bigbadevilaussie-hue/Bike-Mate/bike.png

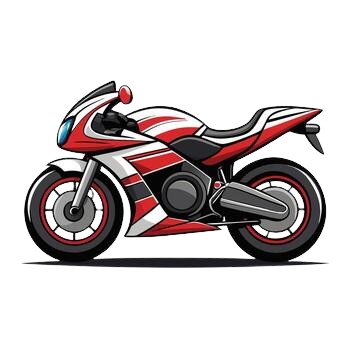
bike.png
