bigbadevilaussie-hue/Bike-Mate/bike_mate_veroboard_layout.png

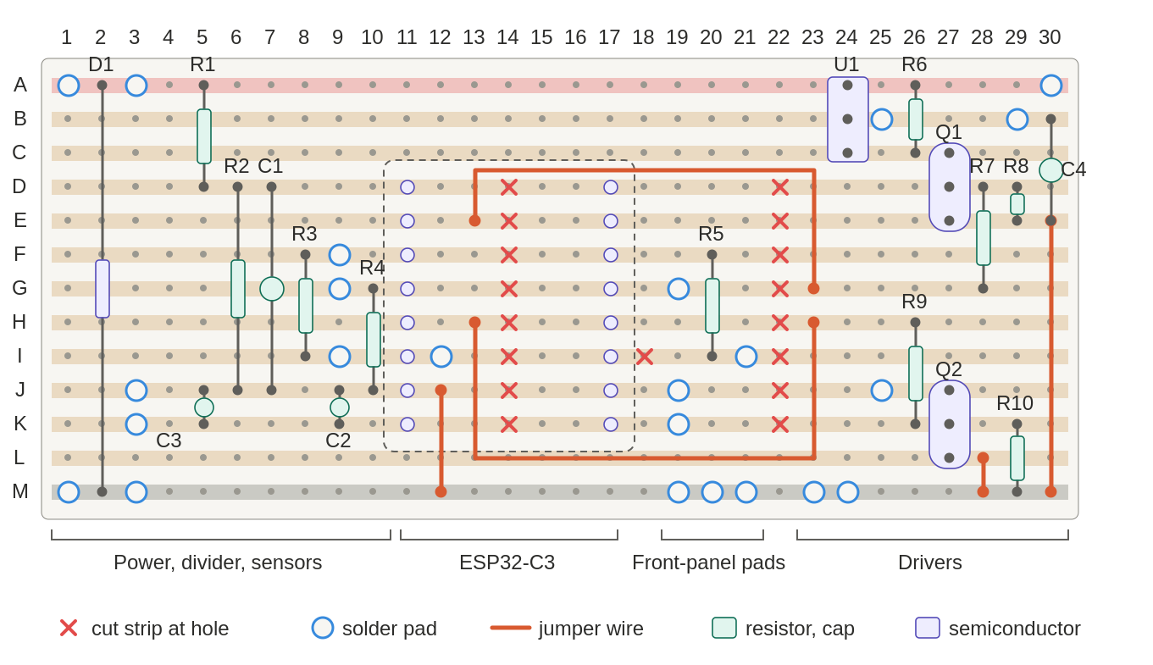
bike_mate_veroboard_layout.png
