bigbadevilaussie-hue/Bike-Mate/bike_mate_veroboard.xlsx

Sheet: Parts
Bike-Mate veroboard: parts (13 strips A-M x 30 holes)
Code | Part | Value | Qty | From hole | To hole | Function / notes | Fitted? (Yes/No)
D1 | TVS diode | SA16CA (bidirectional) | 1 | A2 | M2 | 12 V rail to GND, lay along column 2 | No
R1 | Resistor | 98.8k | 1 | A5 | D5 | Divider top (12 V to GPIO 0 node) | No
R2 | Resistor | 9.98k | 1 | D6 | J6 | Divider bottom (GPIO 0 to GND) | No
C1 | Capacitor | 100 nF ceramic | 1 | D7 | J7 | ADC filter on GPIO 0 | No
R3 | Resistor | 10k | 1 | F8 | I8 | GPS TX pull-up (GPIO 2 to 3V3) | No
R4 | Resistor | 10k | 1 | G10 | J10 | NTC series resistor (GPIO 3 to GND) | No
R5 | Resistor | 330 ohm | 1 | F20 | I20 | Red alarm LED (GPIO 10 to LED anode pad I21) | No
R6 | Resistor | 10k | 1 | A26 | C26 | IRF4905 gate pull-up. Mount upright | No
R7 | Resistor | 1k | 1 | D28 | G28 | Q1 base resistor (from GPIO 1 landing row G) | No
R8 | Resistor | 10k | 1 | D29 | E29 | Q1 base pull-down. Mount upright | No
R9 | Resistor | 1k | 1 | H26 | K26 | Q2 base resistor (from GPIO 4 landing row H) | No
R10 | Resistor | 10k | 1 | K29 | M29 | Q2 base pull-down. Mount upright | No
U1 | P-MOSFET | IRF4905 | 1 | A24 | C24 | Column 24: A = source, B = drain, C = gate | No
Q1 | NPN transistor | 2N2222 | 1 | C27 | E27 | Column 27: C = collector, D = base, E = emitter | No
Q2 | NPN transistor | 2N2222 | 1 | J27 | L27 | Column 27: J = collector, K = base, L = emitter | No
C2 | Capacitor | 100 nF ceramic | 1 | J9 | K9 | Decoupling across SuperMini 5V/GND, close to header (K = 5V, J = GND) | No
C3 | Capacitor | 10-47 uF electrolytic, 16 V or higher | 1 | J5 | K5 | Bulk on 5V rail. + lead to K5 (5V), - lead to J5 (GND) | No
C4 | Capacitor (optional) | 100 nF ceramic | 1 | B30 | E30 | Switched 12V rail near IRF4905 (B = switched 12V, E = GND). Shares hole E30 with W4 | No
Total parts |  |  | 18
Fitted |  |  | 0
Remaining |  |  | 18
Blue text in column H is for you to fill in (Yes or No).

Sheet: Jumpers
Jumper wires (5)
Code | From hole | To hole | Purpose
W1 | J12 | M12 | Module GND row to GND rail
W2 | E13 | G23 | GPIO 1 to IRF4905 driver (R7 landing row). Insulated wire, routed above the module pins
W3 | H13 | H23 | GPIO 4 to buzzer driver (R9 landing row). Insulated wire, routed below the module pins
W4 | E30 | M30 | Q1 emitter row to GND rail
W5 | L28 | M28 | Q2 emitter row to GND rail
Count | 5

Sheet: Pads
Solder pads (wires to off-board parts)
Hole | Net | Connects to | Wired? (Yes/No)
A1 | +12 V rail | 12 V in (after fuse and kill switch) | No
M1 | GND rail | GND in | No
A3 | +12 V rail | MP1584 IN+ | No
M3 | GND rail | MP1584 IN- | No
K3 | 5V | MP1584 OUT+ (5 V to SuperMini) | No
J3 | GND (module row) | MP1584 OUT- | No
F9 | GPIO 2 | GPS TX | No
G9 | GPIO 3 | NTC lead 1 | No
I9 | 3V3 | NTC lead 2 | No
I12 | 3V3 | OLED VCC | No
G19 | GPIO 9 | OLED SCL | No
J19 | GPIO 6 | OLED SDA | No
M20 | GND rail | OLED GND | No
K19 | GPIO 5 | Wake button | No
M19 | GND rail | Wake button return | No
I21 | LED anode net | Red alarm LED anode (via R5) | No
M21 | GND rail | Red alarm LED cathode | No
B25 | Switched 12 V | Mini 360 IN+ (or USB charger +) | No
B29 | Switched 12 V | USB charger + (or Mini 360 IN+) | No
M23 | GND rail | Mini 360 IN- | No
M24 | GND rail | USB charger - | No
A30 | +12 V rail | Buzzer + (SFM-27 red) | No
J25 | Buzzer - net | Buzzer - (SFM-27 black, Q2 collector row) | No
Pads |  | 23
Wired |  | 0

Sheet: Cuts
Strip cuts (remove copper at the hole, check with continuity)
Column | Rows | Purpose | Cuts
14 | D to K | Separates left and right module header groups | 8
22 | D to K | Separates module pad area from driver zone | 8
18 | I only | Isolates unused GPIO 7 pin from the LED pad island | 1
Total cuts |  |  | 17

Sheet: Module pins
SuperMini on rows D-K, USB-C end toward the GND rail (verify against your silkscreen)
Row | Left header (col 11) | Left use | Right header (col 17) | Right use
D | GPIO 0 | Voltage divider node (R1, R2, C1) | GPIO 21 | Unused
E | GPIO 1 | IRF4905 driver via W2 | GPIO 20 | Unused
F | GPIO 2 | GPS TX and R3 pull-up | GPIO 10 | Alarm LED via R5
G | GPIO 3 | NTC network | GPIO 9 | OLED SCL pad (G19)
H | GPIO 4 | Buzzer driver via W3 | GPIO 8 | Unused (onboard LED)
I | 3V3 | 3V3 net (R3, NTC, OLED VCC) | GPIO 7 | Unused
J | GND | GND (tied to rail by W1) | GPIO 6 | OLED SDA pad (J19)
K | 5V | 5 V from MP1584 | GPIO 5 | Wake button pad (K19)

Sheet: Build steps
Build order
Step | Task | Done? (Yes/No)
1 | Trim board to 13 strips x 30 holes
2 | Make the 17 cuts and check each with continuity
3 | Fit female headers at columns 11 and 17 (rows D-K)
4 | Fit resistors, C1 and D1 (stand R6, R8, R10 upright)
5 | Fit U1, Q1 and Q2 (check pin order, flip 180 degrees if needed)
6 | Add the five jumper wires
7 | Wire the pads to the off-board parts
8 | Continuity check: no short between rail A and rail M, no unintended links between rows
9 | Power up without the SuperMini: confirm 5 V, 3V3 and GND at its sockets
10 | Insert the SuperMini, then check voltage reading and sleep current
Progress |  | 0%

Sheet: Notes
Assumptions and checks
Layout designed from veroboard.txt (Bike-Mate V5.63). It is untested: verify every cut and connection with a continuity tester before powering.
Grid: rows A-M are strips running left to right, columns 1-30. Row A is the +12 V rail, row M is the GND rail.
Module headers assumed 6 holes apart (columns 11 and 17). If yours are 7 holes apart, shift everything right of the module by one column and move the first cut to the midpoint.
SuperMini pin order assumed: left header GPIO 0,1,2,3,4,3V3,GND,5V; right header GPIO 21,20,10,9,8,7,6,5 (USB-C toward the GND rail). Confirm against your board.
Check 2N2222 and IRF4905 pin order; flip each part 180 degrees if the collector or gate lands on the wrong row.
R6, R8 and R10 have only 1-2 holes between their rows, so mount them upright.
MP1584, Mini 360, USB charger, GPS, fan, OLED, buzzer, NTC, button and LED connect by wire to the pads; their footprints are not on the board.
C2, C3 and C4 were added after the first layout (recommended extra capacitors). C4 is optional.
GPIO 2 and GPIO 9 are strapping pins and must be high at reset. Measure sleep current with ACC off (see veroboard.txt known issues).
