bigbadevilaussie-hue/Bike-Mate/Bike-Mate-Case.3mf

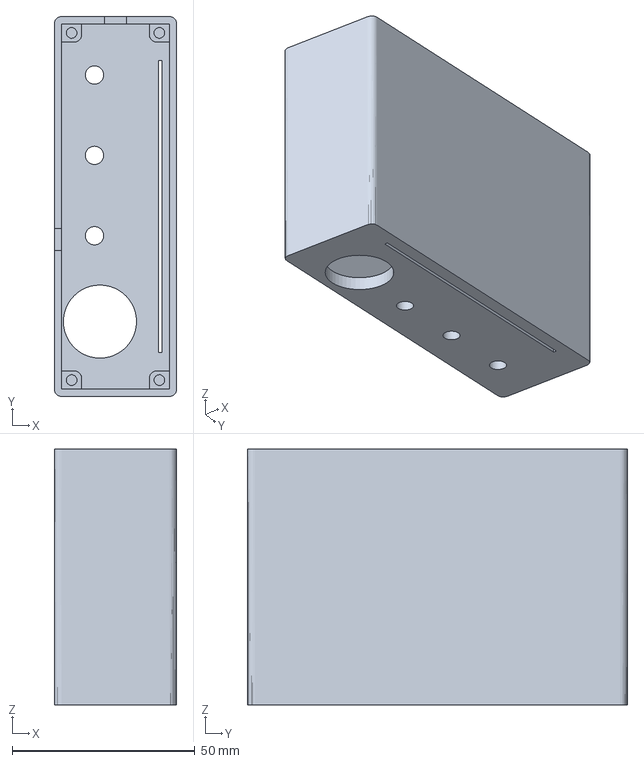
[picture p3: CAD file, 2026-10-31]
Bike-Mate-Case.3mf
33.5 x 104.0 x 70.0 mm
