bigbadevilaussie-hue/Bike-Mate/(list of files, cad)

Other CAD files:
Bike-Mate-Case.stl
