bigbadevilaussie-hue/Bike-Mate/bike_mate.kicad_sch

## KiCad design bike_mate.kicad_sch (2026-10-15)

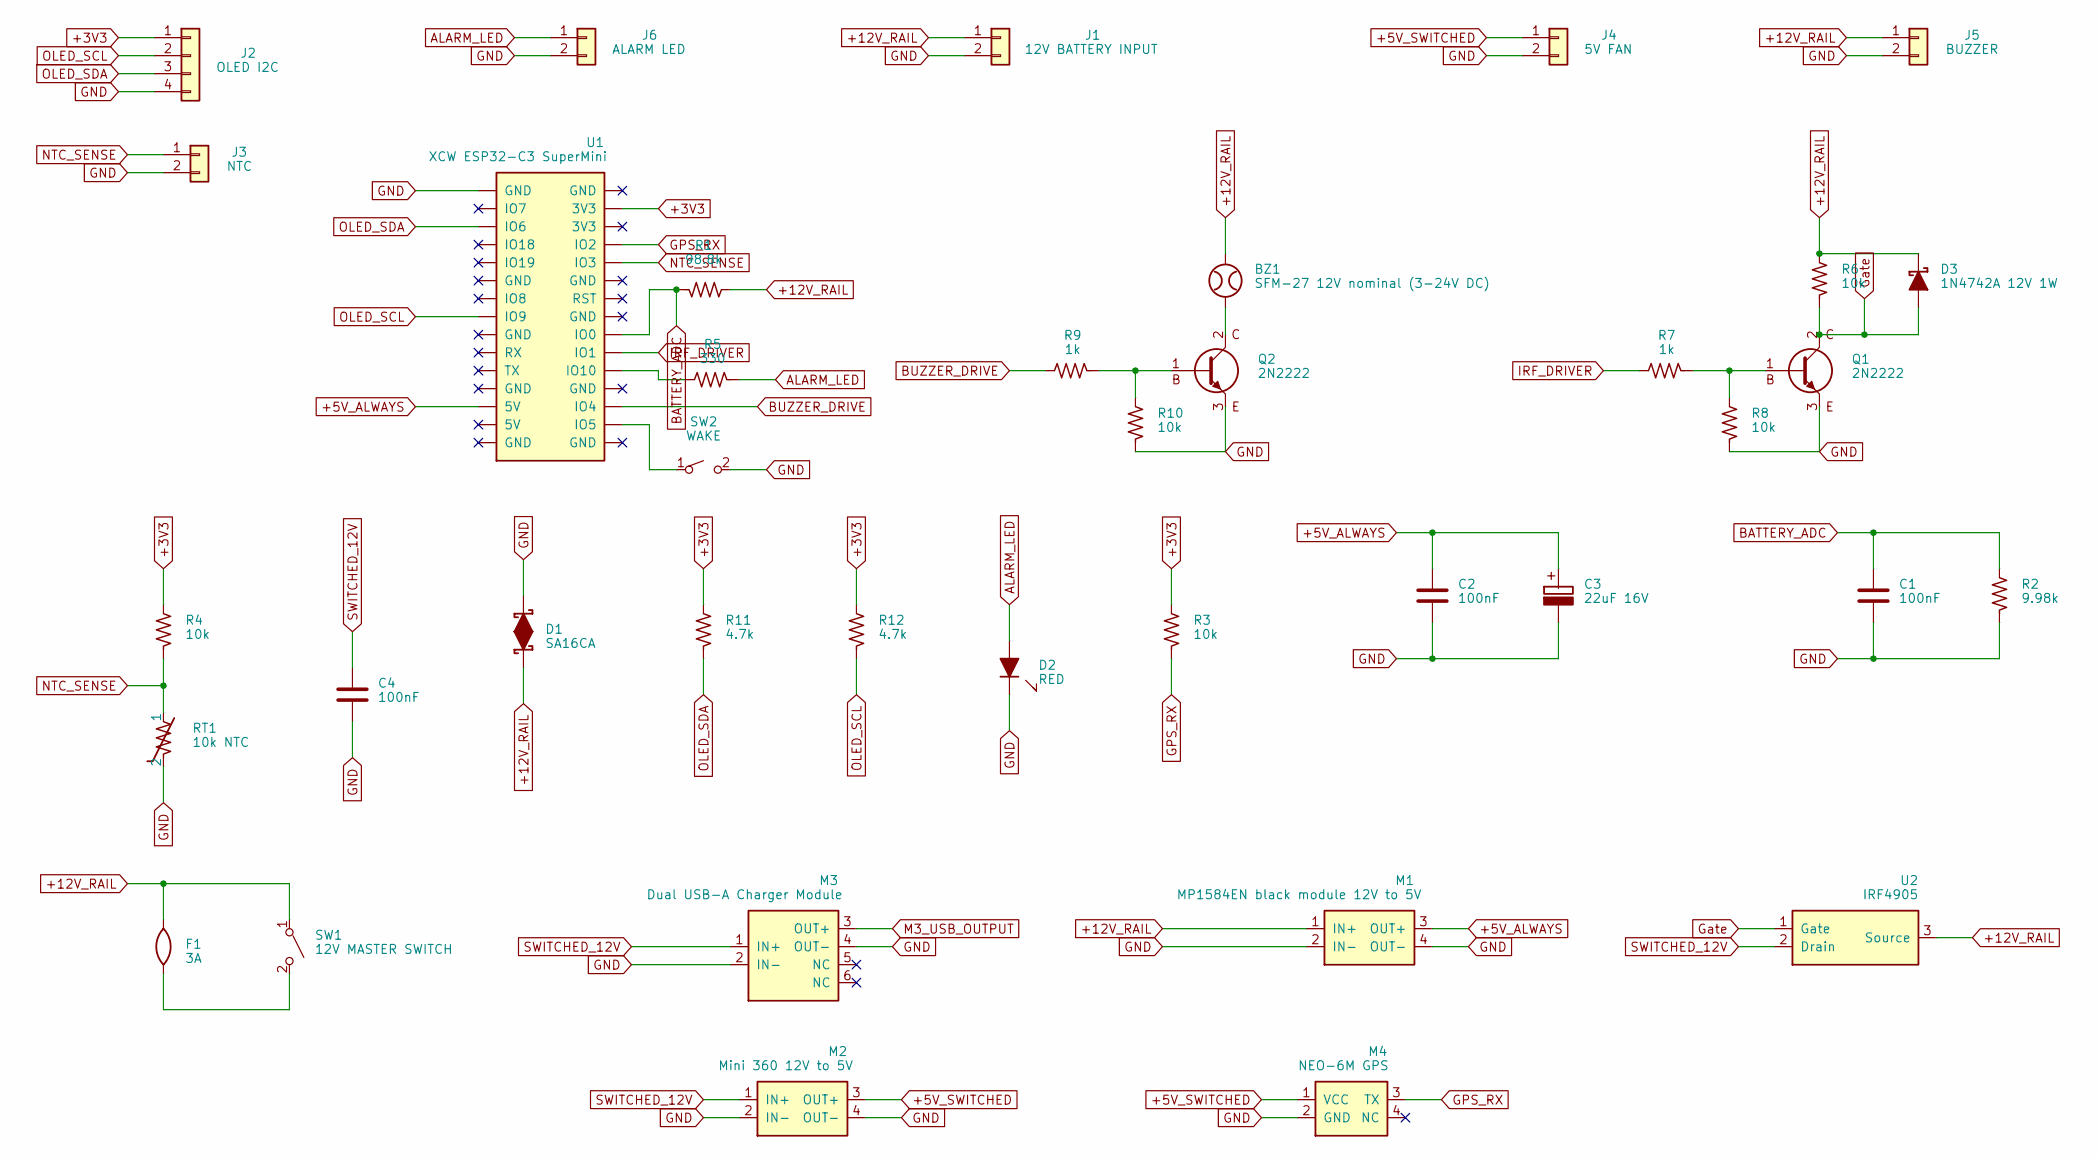
[picture p5: schematic bike_mate.kicad_sch]

Parts:
BZ1: SFM-27 12V nominal (3-24V DC)
C1, C2, C4: 100nF
C3: 22uF 16V
D1: SA16CA
D2: RED
D3: 1N4742A 12V 1W
F1: 3A
J1: 12V BATTERY INPUT
J2: OLED I2C
J3: NTC
J4: 5V FAN
J5: BUZZER
J6: ALARM LED
M1: MP1584EN black module 12V to 5V
M2: Mini 360 12V to 5V
M3: Dual USB-A Charger Module
M4: NEO-6M GPS
Q1, Q2: 2N2222
R1: 98.8k
R2: 9.98k
R3, R4, R6, R8, R10: 10k
R5: 330
R7, R9: 1k
R11, R12: 4.7k
RT1: 10k NTC
SW1: 12V MASTER SWITCH
SW2: WAKE
U1: XCW ESP32-C3 SuperMini
U2: IRF4905

Connections:
+3V3: J2.1, R3.1, R4.1, R11.1, R12.1, U1.3V3_1 (3V3)
+5V_ALWAYS: C2.1, C3.1, M1.3 (OUT+), U1.5V_1 (5V)
+5V_SWITCHED: J4.1, M2.3 (OUT+), M4.1 (VCC)
+12V_RAIL: BZ1.1 (+), D1.1, D3.1 (K), F1.2, J1.1, J5.1, M1.1 (IN+), R1.1, R6.1, SW1.1, U2.3 (Source)
ALARM_LED: D2.2 (A), J6.1, R5.2
BATTERY_ADC: C1.1, R1.2, R2.1, U1.GPIO0 (IO0)
BUZZER_DRIVE: R9.1, U1.GPIO4 (IO4)
GND: C1.2, C2.2, C3.2, C4.2, D1.2, D2.1 (K), J1.2, J2.4, J3.2, J4.2, J5.2, J6.2, M1.2 (IN-), M1.4 (OUT-), M2.2 (IN-), M2.4 (OUT-), M3.2 (IN-), M3.4 (OUT-), M4.2 (GND), Q1.3 (E), Q2.3 (E), R2.2, R8.2, R10.2, RT1.2, SW2.2, U1.GND1 (GND)
GPS_RX: M4.3 (TX), R3.2, U1.GPIO2 (IO2)
Gate: D3.2 (A), Q1.2 (C), R6.2, U2.1 (Gate)
IRF_DRIVER: R7.1, U1.GPIO1 (IO1)
M3_USB_OUTPUT: M3.3 (OUT+)
NTC_SENSE: J3.1, R4.2, RT1.1, U1.GPIO3 (IO3)
unnamed: BZ1.2 (-), Q2.2 (C)
unnamed: F1.1, SW1.2
unnamed: Q1.1 (B), R7.2, R8.1
unnamed: Q2.1 (B), R9.2, R10.1
unnamed: R5.1, U1.GPIO10 (IO10)
unnamed: SW2.1, U1.GPIO5 (IO5)
OLED_SCL: J2.2, R12.2, U1.GPIO9 (IO9)
OLED_SDA: J2.3, R11.2, U1.GPIO6 (IO6)
SWITCHED_12V: C4.1, M2.1 (IN+), M3.1 (IN+), U2.2 (Drain)
