bigbadevilaussie-hue/Bike-Mate/BleManager.cpp

#include "BleManager.h"
#include "Config.h"
#include "RideLogger.h"
#include "RideStorage.h"
#include "Settings.h"

#include <Preferences.h>
#include <esp_bt.h>
#include <LittleFS.h>
#include <string>
#include <time.h>

extern Preferences prefs;
extern uint32_t currentEpoch();
extern void tprint(const char* fmt, ...);
extern unsigned long lastDisconnectMillis;

extern bool gpsHasFix();
extern int32_t gpsLat_x1e7();
extern int32_t gpsLon_x1e7();
extern uint8_t gpsSats();

BLEServer* pServer = nullptr;
BLECharacteristic* pDataChar = nullptr;
BLECharacteristic* pTimeChar = nullptr;
BLECharacteristic* pStreamChar = nullptr;
BLECharacteristic* pRequestChar = nullptr;
BLECharacteristic* pOtaChar = nullptr;
BLECharacteristic* pSettingsChar = nullptr;
BLECharacteristic* pUploadChar = nullptr;   // V5.37
volatile bool maintenanceModeRequested = false;
volatile unsigned long lastBleWriteMs = 0;   // V4.84: last incoming BLE write

bool bleInited = false;

// V5.37.7: set while bleSendFile is transferring. Read by
// DisplayManager to show the upload screen on the OLED.
volatile bool bleUploadActive = false;

volatile bool pushRequested = false;
volatile bool pushInProgress = false;
volatile uint32_t pushGuiEpoch = 0;

// V5.77: Heartbeat tracking
RTC_DATA_ATTR uint32_t _bootCount = 0;
static unsigned long _lastHbMs = 0;

// V5.76: ACK queue. onWrite just queues the filename.
// The main loop processes it, so we don't run LittleFS inside the BT task.
#define ACK_QUEUE_SIZE 8
static char _ackQueue[ACK_QUEUE_SIZE][48];
static volatile int _ackHead = 0;
static volatile int _ackTail = 0;

static volatile bool bleSuspended = false;

extern float latestBatteryVoltage;
extern float latestTemperatureC;
extern bool accState;
extern bool engineWasRunning;
extern bool inPanic;
extern bool isLogging;
extern const char* currentStateString();

bool isActuallyConnected() {
  return pServer && pServer->getConnectedCount() > 0;
}

void bleStop() {
  if (!bleInited) return;

  bleSuspended = true;

  delay(50);

  if (pServer) {
    pServer->getAdvertising()->stop();

    if (pServer->getConnectedCount() > 0) {
      pServer->disconnect(pServer->getConnId());
    }
  }

  // V4.86: wait for the BT controller to actually go idle before
  // returning. WiFi bring-up tears down and re-inits the shared radio;
  // if the BT side is still mid-teardown the WiFi driver never leaves
  // WL_IDLE_STATUS and association times out. Bounded so a stuck
  // controller can't pin us here.
  unsigned long t0 = millis();
  while (millis() - t0 < 2000UL) {
    esp_bt_controller_status_t st = esp_bt_controller_get_status();
    if (st == ESP_BT_CONTROLLER_STATUS_IDLE ||
        st == ESP_BT_CONTROLLER_STATUS_INITED) {
      break;
    }
    delay(20);
  }

  delay(200);
}

void bleStart() {
  if (!bleInited) return;

  bleSuspended = false;

  if (pServer) {
    pServer->getAdvertising()->start();
  }
}

static bool isHeaderLine(const String& line) {
  if (line.length() == 0) return true;
  if (line.startsWith("#")) return true;
  if (line.startsWith("epoch,")) return true;
  return false;
}

void pushNewSlots(uint32_t guiHighestEpoch) {
  pushInProgress = true;

  prefs.begin("rides", true);

  uint32_t newestEpoch = prefs.getUInt("newest_epoch", 0);

  RideSummary newest;
  memset(&newest, 0, sizeof(newest));

  if (newestEpoch > 0) {
    char key[16];

    snprintf(key, sizeof(key), "s%lu",
             (unsigned long)newestEpoch);

    size_t sz = prefs.getBytes(
        key,
        &newest,
        sizeof(newest));

    if (sz != sizeof(newest)) {
      newestEpoch = 0;
    }
  }

  prefs.end();

  if (newestEpoch == 0) {
    uint8_t r = 0x00;

    if (pRequestChar) {
      pRequestChar->setValue(&r, 1);
      pRequestChar->notify();
    }

    pushInProgress = false;
    return;
  }

  if (newestEpoch <= guiHighestEpoch) {
    uint8_t r = 0x00;

    if (pRequestChar) {
      pRequestChar->setValue(&r, 1);
      pRequestChar->notify();
    }

    pushInProgress = false;
    return;
  }

  uint8_t r = 0x01;

  if (pRequestChar) {
    pRequestChar->setValue(&r, 1);
    pRequestChar->notify();
  }

  delay(80);

  pStreamChar->setValue(
      (uint8_t*)&newest,
      sizeof(newest));

  pStreamChar->notify();

  delay(100);

  char path[40];

  setenv("TZ", "AEST-10", 1);
  tzset();

  rideStorageBuildFilename(
      newestEpoch,
      path,
      sizeof(path));

  File f = LittleFS.open(path, "r");

  if (!f) {
    tprint("[PUSH] file not found %s (clearing newest_epoch)", path);

    prefs.begin("rides", false);
    prefs.putUInt("newest_epoch", 0);
    prefs.end();

    r = 0x00;

    if (pRequestChar) {
      pRequestChar->setValue(&r, 1);
      pRequestChar->notify();
    }

    pushInProgress = false;
    return;
  }

  while (f.available()) {
    int peek = f.peek();

    if (peek == '#' || peek == 'e') {
      f.readStringUntil('\n');
    } else {
      break;
    }
  }

  uint16_t sent = 0;
  uint8_t buf[8];

  while (f.available() && sent < newest.rowCount) {
    String line = f.readStringUntil('\n');

    if (isHeaderLine(line)) {
      continue;
    }

    uint32_t ep = 0;
    int32_t lat = 0;
    int32_t lon = 0;
    float v = 0;
    int temp = 0;
    int sats = 0;

    int parsed = sscanf(
        line.c_str(),
        "%lu,%ld,%ld,%f,%d,%d",
        (unsigned long*)&ep,
        (long*)&lat,
        (long*)&lon,
        &v,
        &temp,
        &sats);

    if (parsed < 6) {
      continue;
    }

    uint16_t v100 = (uint16_t)(v * 100);

    memcpy(buf + 0, &ep, 4);
    memcpy(buf + 4, &v100, 2);

    buf[6] = (uint8_t)temp;
    buf[7] = (uint8_t)sats;

    pStreamChar->setValue(buf, 8);
    pStreamChar->notify();

    sent++;

    delay(40);
  }

  f.close();

  if (isActuallyConnected()) {
    r = 0x02;

    if (pRequestChar) {
      pRequestChar->setValue(&r, 1);
      pRequestChar->notify();
    }
  }

  delay(100);

  pushInProgress = false;
}

class ServerCallbacks : public BLEServerCallbacks {
  void onConnect(BLEServer* s) {

    delay(300);

    char vbuf[32];

    snprintf(
        vbuf,
        sizeof(vbuf),
        "{\"fv\":\"%s\"}",
        BIKE_MATE_VERSION);

    if (pDataChar) {
      pDataChar->setValue(
          (uint8_t*)vbuf,
          strlen(vbuf));

      pDataChar->notify();
    }
  }

  void onDisconnect(BLEServer* s) {
    lastDisconnectMillis = millis();

    if (!bleSuspended && pServer) {
      pServer->getAdvertising()->start();
    }
  }
};

class TimeCallbacks : public BLECharacteristicCallbacks {
  void onWrite(BLECharacteristic* c) {
    lastBleWriteMs = millis();
    std::string v = c->getValue();

    if (v.length() < 4) return;

    uint32_t t = 0;

    memcpy(&t, v.c_str(), 4);

    if (t < 1700000000UL ||
        t > 4102444800UL) {
      return;
    }

    struct timeval tv = { .tv_sec = (time_t)t, .tv_usec = 0 };
    settimeofday(&tv, NULL);
  }
};

class RequestCallbacks : public BLECharacteristicCallbacks {
  void onWrite(BLECharacteristic* c) {
    lastBleWriteMs = millis();
    std::string v = c->getValue();

    if (v.length() < 4) return;

    uint32_t epoch = 0;

    memcpy(&epoch, v.c_str(), 4);

    pushGuiEpoch = epoch;
    pushRequested = true;
  }
};

class OtaCallbacks : public BLECharacteristicCallbacks {
  void onWrite(BLECharacteristic* c) {
    lastBleWriteMs = millis();
    std::string v = c->getValue();

    // Settings read: single byte 0x01 -> notify JSON on same characteristic
    if (v.length() == 1 && (uint8_t)v[0] == 0x01) {
      char sbuf[192];
      settingsToJson(sbuf, sizeof(sbuf));
      pOtaChar->setValue((uint8_t*)sbuf, strlen(sbuf));
      pOtaChar->notify();
      tprint("[SETTINGS] read served: %s", sbuf);
      return;
    }

    // V4.75: maintenance mode command. Payload is {"maint":"on"} or {"maint":"off"}.
    // "on" -> set flag, ACK over BLE, then main loop brings WiFi up.
    // "off" -> ignored here; the off path is HTTP /maint/off, since BLE
    //          is dead while maintenance is running.
    if (v.length() > 1) {
      String mv = String(v.c_str());
      int mi = mv.indexOf("\"maint\":\"");
      if (mi >= 0) {
        int vs = mi + 9;
        int ve = mv.indexOf("\"", vs);
        if (ve > vs) {
          String val = mv.substring(vs, ve);
          if (val == "on") {
            extern bool maintRequest;
            maintRequest = true;
            uint8_t ack = 0x01;
            pOtaChar->setValue(&ack, 1);
            pOtaChar->notify();
            tprint("[MAINT] on requested (flag set, will act on next wake)");
          } else if (val == "off") {
            uint8_t nack = 0x02;
            pOtaChar->setValue(&nack, 1);
            pOtaChar->notify();
            tprint("[MAINT] off over BLE ignored, use /maint/off");
          } else {
            uint8_t nack = 0xFF;
            pOtaChar->setValue(&nack, 1);
            pOtaChar->notify();
            tprint("[MAINT] unknown value");
          }
        }
        return;
      }
    }

    // V5.37.6: manual upload trigger from OSA. Payload is {"cmd":"upload"}.
    // Sets a flag the main loop reads on the next doStateWork pass,
    // which runs the same BLE-send path the 04:00 schedule uses.
    if (v.length() > 1) {
      String cv = String(v.c_str());
      if (cv.indexOf("\"cmd\":\"upload\"") >= 0) {
        extern bool bleUploadNowRequested;
        bleUploadNowRequested = true;
        uint8_t ack = 0x01;
        pOtaChar->setValue(&ack, 1);
        pOtaChar->notify();
        tprint("[UPLOAD] manual trigger over BLE (flag set)");
        return;
      }
    }

    // Settings apply: multi-byte payload containing "voltage"
    if (v.length() > 1) {
      String sv = String(v.c_str());
      if (sv.indexOf("\"voltage\"") >= 0) {
        if (settingsApplyJson(sv.c_str())) {
          uint8_t ok = 0x01;
          pOtaChar->setValue(&ok, 1);
          pOtaChar->notify();
          tprint("[SETTINGS] apply OK");
        } else {
          uint8_t err = 0xFF;
          pOtaChar->setValue(&err, 1);
          pOtaChar->notify();
          tprint("[SETTINGS] apply FAIL");
        }
        return;
      }
    }

    // V5.76: OSA acks a file transfer. Queue the filename.
    // The main loop deletes it. Never touch LittleFS or tprint here.
    if (v.length() > 1) {
      String av = String(v.c_str());
      int ai = av.indexOf("\"ack\":");
      if (ai >= 0) {
        int as = ai + 6;
        while (as < (int)av.length() && av[as] == ' ') as++;
        int q1 = av.indexOf("\"", as);
        if (q1 >= as) {
          int q2 = av.indexOf("\"", q1 + 1);
          if (q2 > q1) {
            String fname = av.substring(q1 + 1, q2);
            int next = (_ackHead + 1) % ACK_QUEUE_SIZE;
            if (next != _ackTail) {
              snprintf(_ackQueue[_ackHead], sizeof(_ackQueue[_ackHead]), "%s", fname.c_str());
              _ackHead = next;
            }
          }
        }
        return;
      }
    }

    if (v.length() < 8) {
      uint8_t nack = 0xFF;

      pOtaChar->setValue(&nack, 1);
      pOtaChar->notify();

      return;
    }

    String payload = String(v.c_str());

    int urlIdx = payload.indexOf("\"url\":\"");
    int urlEnd = payload.indexOf("\"", urlIdx + 7);

    if (urlIdx < 0 || urlEnd < 0) {
      tprint("[OTA] parse: no url");

      uint8_t nack = 0xFF;

      pOtaChar->setValue(&nack, 1);
      pOtaChar->notify();

      return;
    }

    String url =
        payload.substring(urlIdx + 7, urlEnd);

    uint32_t size = 0;

    int sizeIdx =
        payload.indexOf("\"size\":");

    if (sizeIdx > 0) {
      int sizeEnd =
          payload.indexOf(",", sizeIdx);

      if (sizeEnd < 0) {
        sizeEnd =
            payload.indexOf("}", sizeIdx);
      }

      if (sizeEnd > 0) {
        String sizeStr =
            payload.substring(
                sizeIdx + 7,
                sizeEnd);

        size = (uint32_t)sizeStr.toInt();
      }
    }

    String md5 = "";

    int md5Idx =
        payload.indexOf("\"md5\":\"");

    if (md5Idx >= 0) {
      int md5End =
          payload.indexOf("\"", md5Idx + 7);

      if (md5End > 0) {
        md5 =
            payload.substring(
                md5Idx + 7,
                md5End);
      }
    }

    String ver = "";

    int verIdx =
        payload.indexOf("\"ver\":\"");

    if (verIdx >= 0) {
      int verEnd =
          payload.indexOf("\"", verIdx + 7);

      if (verEnd > 0) {
        ver =
            payload.substring(
                verIdx + 7,
                verEnd);
      }
    }

    extern volatile bool otaRequest;
    extern char otaUrl[];
    extern uint32_t otaSize;
    extern char otaMd5[];
    extern char otaVersion[16];
    extern unsigned long otaStartMillis;

    if (url.length() == 0 ||
        url.length() >= OTA_URL_MAX) {

      tprint("[OTA] url bad length");

      uint8_t nack = 0xFF;

      pOtaChar->setValue(&nack, 1);
      pOtaChar->notify();

      return;
    }

    strncpy(
        otaUrl,
        url.c_str(),
        OTA_URL_MAX - 1);

    otaUrl[OTA_URL_MAX - 1] = 0;

    otaSize = size;

    strncpy(
        otaMd5,
        md5.c_str(),
        OTA_MD5_LEN - 1);

    otaMd5[OTA_MD5_LEN - 1] = 0;

    strncpy(
        otaVersion,
        ver.c_str(),
        15);

    otaVersion[15] = 0;

    otaStartMillis = millis();
    otaRequest = true;

    uint8_t ack = 0x01;

    pOtaChar->setValue(&ack, 1);
    pOtaChar->notify();
  }
};

class SettingsCallbacks : public BLECharacteristicCallbacks {
  void onWrite(BLECharacteristic* c) override {
    lastBleWriteMs = millis();
    std::string v = c->getValue();
    if (v.length() == 0) return;

    // Read request: single byte 0x01 -> send current settings via notify
    if (v.length() == 1 && (uint8_t)v[0] == 0x01) {
      char sbuf[192];
      settingsToJson(sbuf, sizeof(sbuf));
      pSettingsChar->setValue((uint8_t*)sbuf, strlen(sbuf));
      pSettingsChar->notify();
      tprint("[SETTINGS] read request served: %s", sbuf);
      return;
    }

    String payload = String(v.c_str());
    tprint("[SETTINGS] RX: %s", payload.c_str());
    if (settingsApplyJson(payload.c_str())) {
      uint8_t ok = 0x01;
      pSettingsChar->setValue(&ok, 1);
      pSettingsChar->notify();
      tprint("[SETTINGS] apply OK");
    } else {
      uint8_t err = 0xFF;
      pSettingsChar->setValue(&err, 1);
      pSettingsChar->notify();
      tprint("[SETTINGS] apply FAIL");
    }
  }
};

void bleInit() {
  if (bleInited) return;
  _bootCount++;

  BLEDevice::init(DEVICE_NAME);
  BLEDevice::setMTU(185);

  pServer = BLEDevice::createServer();

  pServer->setCallbacks(
      new ServerCallbacks());

  BLEService* svc =
      pServer->createService(BLEUUID(SERVICE_UUID), 30, 0);

  pDataChar = svc->createCharacteristic(
      DATA_UUID,
      BLECharacteristic::PROPERTY_READ |
      BLECharacteristic::PROPERTY_NOTIFY);

  pDataChar->addDescriptor(
      new BLE2902());

  pTimeChar = svc->createCharacteristic(
      TIME_UUID,
      BLECharacteristic::PROPERTY_WRITE);

  pTimeChar->setCallbacks(
      new TimeCallbacks());

  pStreamChar = svc->createCharacteristic(
      STREAM_UUID,
      BLECharacteristic::PROPERTY_NOTIFY);

  pStreamChar->addDescriptor(
      new BLE2902());

  pRequestChar = svc->createCharacteristic(
      REQUEST_UUID,
      BLECharacteristic::PROPERTY_WRITE |
      BLECharacteristic::PROPERTY_NOTIFY);

  pRequestChar->addDescriptor(
      new BLE2902());

  pRequestChar->setCallbacks(
      new RequestCallbacks());

  pOtaChar = svc->createCharacteristic(
      OTA_UUID,
      BLECharacteristic::PROPERTY_WRITE |
      BLECharacteristic::PROPERTY_NOTIFY);

  pOtaChar->addDescriptor(
      new BLE2902());

  pOtaChar->setCallbacks(
      new OtaCallbacks());

  pSettingsChar = svc->createCharacteristic(
      SETTINGS_UUID,
      BLECharacteristic::PROPERTY_READ |
      BLECharacteristic::PROPERTY_WRITE |
      BLECharacteristic::PROPERTY_NOTIFY);
  pSettingsChar->addDescriptor(new BLE2902());
  pSettingsChar->setCallbacks(new SettingsCallbacks());
  {
    char sbuf[192];
    settingsToJson(sbuf, sizeof(sbuf));
    pSettingsChar->setValue((uint8_t*)sbuf, strlen(sbuf));
  }

  pUploadChar = svc->createCharacteristic(
      UPLOAD_UUID,
      BLECharacteristic::PROPERTY_NOTIFY);

  pUploadChar->addDescriptor(
      new BLE2902());

  svc->start();

  BLEAdvertising* adv =
      BLEDevice::getAdvertising();

  adv->addServiceUUID(SERVICE_UUID);
  adv->setScanResponse(true);

  bleInited = true;
}

extern const char* currentWakeMode();

// V5.37: send a file over BLE in 180-byte chunks.
bool bleSendFile(const char* path, const char* uploadName) {
  if (!pUploadChar || !bleInited) return false;
  if (!isActuallyConnected()) return false;

  bleUploadActive = true;

  File f = LittleFS.open(path, "r");
  if (!f) {
    tprint("[BLEUP] cannot open %s", path);
    bleUploadActive = false;
    return false;
  }

  size_t total = f.size();
  if (total == 0) { f.close(); bleUploadActive = false; return true; }

  uint8_t hdr[181];
  hdr[0] = 0x01;
  memcpy(hdr + 1, &total, 4);
  size_t nameLen = strlen(uploadName);
  if (nameLen > 176) nameLen = 176;
  memset(hdr + 5, 0, 176);
  memcpy(hdr + 5, uploadName, nameLen);
  pUploadChar->setValue(hdr, 181);
  pUploadChar->notify();
  delay(60);

  uint8_t buf[181];
  buf[0] = 0x02;
  size_t sent = 0;
  while (sent < total) {
    size_t n = f.read(buf + 1, 180);
    if (n == 0) break;
    if (n < 180) memset(buf + 1 + n, 0, 180 - n);
    pUploadChar->setValue(buf, 181);
    pUploadChar->notify();
    sent += n;
    delay(35);
  }
  f.close();

  uint8_t endBuf[5];
  endBuf[0] = 0x03;
  uint32_t crc = 0;
  memcpy(endBuf + 1, &crc, 4);
  pUploadChar->setValue(endBuf, 5);
  pUploadChar->notify();
  delay(40);

  tprint("[BLEUP] sent %s (%u bytes)", uploadName, (unsigned)total);
  bleUploadActive = false;
  return (sent == total);
}

void processAckQueue() {
  while (_ackTail != _ackHead) {
    char fname[48];
    strncpy(fname, _ackQueue[_ackTail], sizeof(fname) - 1);
    fname[sizeof(fname) - 1] = 0;
    _ackTail = (_ackTail + 1) % ACK_QUEUE_SIZE;

    String path = fname;
    if (!path.startsWith("/")) path = "/" + path;
    if (LittleFS.exists(path)) {
      LittleFS.remove(path);
      tprint("[BLEUP] deleted %s", path.c_str());
    }
  }
}

void publishBLE() {
  if (!pDataChar || !bleInited) return;
  if (!isActuallyConnected()) return;
  if (pushInProgress) return;

  int32_t lat = gpsLat_x1e7();
  int32_t lon = gpsLon_x1e7();

  // V5.23: storage telemetry. used/total bytes in LittleFS.
  uint32_t _fsTotal = LittleFS.totalBytes();
  uint32_t _fsUsed  = LittleFS.usedBytes();
  uint8_t  storagePercent = (_fsTotal > 0)
                            ? (uint8_t)((_fsUsed * 100) / _fsTotal)
                            : 0;

  // V5.70: Count how many files need uploading
  int fileCount = 0;
  File root = LittleFS.open("/");
  if (root && root.isDirectory()) {
    File e = root.openNextFile();
    while (e) {
      String n = String(e.name());
      e.close();
      bool isWakeGz = (n.startsWith("/wakes_") || n.startsWith("wakes_")) && n.endsWith(".gz");
      bool isRideGz = (n.startsWith("/ride_") || n.startsWith("ride_")) && n.endsWith(".gz");
      if (isWakeGz || isRideGz) {
        fileCount++;
      }
      e = root.openNextFile();
    }
    root.close();
  }

  char buf[300];
  snprintf(
      buf,
      sizeof(buf),
      "{\"v\":%.2f,\"t\":%.1f,\"a\":%d,\"e\":%d,\"w\":%d,\"s\":\"%s\",\"p\":%d,\"ll\":\"%ld.%04ld,%ld.%04ld\",\"lg\":%d,\"gs\":%d,\"fv\":\"%s\",\"st\":%u,\"n\":%d,\"wm\":\"%s\",\"ts\":%lu}",
      latestBatteryVoltage,
      latestTemperatureC,
      accState ? 1 : 0,
      engineWasRunning ? 1 : 0,
      inPanic ? 1 : 0,
      currentStateString(),
      inPanic ? 1 : 0,
      (long)(lat / 10000000),
      (long)(labs((lat % 10000000) / 1000)),
      (long)(lon / 10000000),
      (long)(labs((lon % 10000000) / 1000)),
      isLogging ? 1 : 0,
      (int)gpsSats(),
      BIKE_MATE_VERSION,
      (unsigned)storagePercent,
      fileCount,
      currentWakeMode(),
      (unsigned long)currentEpoch());

  pDataChar->setValue(
      (uint8_t*)buf,
      strlen(buf));

  pDataChar->notify();

  // V5.74: If we have files, push them now, before sleeping.
  if (fileCount > 0) {
    extern bool bleSendFile(const char* path, const char* uploadName);
    File root2 = LittleFS.open("/");
    if (root2 && root2.isDirectory()) {
      File e2 = root2.openNextFile();
      while (e2) {
        String n = String(e2.name());
        size_t sz = e2.size();
        e2.close();
        bool isWakeGz = (n.startsWith("/wakes_") || n.startsWith("wakes_")) && n.endsWith(".gz");
        bool isRideGz = (n.startsWith("/ride_") || n.startsWith("ride_")) && n.endsWith(".gz");
        if ((isWakeGz || isRideGz) && sz > 0) {
          String path = n.startsWith("/") ? n : "/" + n;
          String uploadName = n;
          int sealedIdx = uploadName.indexOf(".sealed");
          if (sealedIdx >= 0) {
            uploadName = uploadName.substring(0, sealedIdx) + ".gz";
          }
          tprint("[UPLOAD] BLE sending %s", uploadName.c_str());
          bleSendFile(path.c_str(), uploadName.c_str());
          delay(100);
        }
        e2 = root2.openNextFile();
      }
      root2.close();
    }
  }
}

// V5.77: Separate heartbeat notification over STREAM_UUID.
// Keeps the main telemetry JSON small and avoids BLE MTU fragmentation.
void publishHeartbeat() {
  if (!pStreamChar || !bleInited) return;
  if (!isActuallyConnected()) return;
  if (pushInProgress) return; // don't interfere with GUI ride sync

  unsigned long now = millis();
  if (now - _lastHbMs < 2000) return;
  _lastHbMs = now;

  char hbBuf[160];
  snprintf(hbBuf, sizeof(hbBuf),
    "{\"hb\":{\"h\":%u,\"mn\":%u,\"st\":%u,\"up\":%lu,\"rst\":%u,\"pn\":%d,\"lg\":%d}}",
    ESP.getFreeHeap(),
    ESP.getMinFreeHeap(),
    uxTaskGetStackHighWaterMark(NULL),
    now / 1000,
    _bootCount,
    inPanic ? 1 : 0,
    isLogging ? 1 : 0
  );

  pStreamChar->setValue((uint8_t*)hbBuf, strlen(hbBuf));
  pStreamChar->notify();
}
