bigbadevilaussie-hue/Bike-Mate/WebServer.cpp

#include "WebServer.h"
#include "Config.h"
#include "SerialBuffer.h"
#include "DisplayManager.h"
#include "OtaManager.h"
#include "Settings.h"

#include <WebServer.h>
#include <Update.h>
#include <Preferences.h>

extern void tprint(const char* fmt, ...);
extern void tprint_verbose(const char* fmt, ...);
extern uint32_t currentEpoch();
extern bool wakeLoggerSealManual(uint32_t triggerEpoch);

static WebServer server(80);
static bool running = false;

volatile bool maintOffRequested = false;

static void handleSerialPage() {
  String html = R"rawliteral(<!DOCTYPE html><html><head>
<meta charset="utf-8"><title>Bike-Mate Serial</title>
<style>
body{font-family:ui-monospace,monospace;background:#181825;color:#cdd6f4;padding:20px;font-size:13px}
h1{color:#89b4fa;margin:0 0 14px}
.top{display:flex;justify-content:space-between;align-items:center;margin-bottom:14px}
#log{background:#232334;padding:14px;border-radius:8px;height:80vh;overflow-y:auto;white-space:pre-wrap;word-break:break-all}
button{background:#313145;color:#cdd6f4;border:1px solid #45475a;padding:6px 12px;border-radius:6px;font-family:inherit;font-size:12px;cursor:pointer}
button:hover{background:#45475a}
</style>
<script>
function refresh(){
  fetch('/serial-raw').then(r=>r.text()).then(t=>{
    var el=document.getElementById('log');
    var atBottom = el.scrollHeight - el.scrollTop - el.clientHeight < 50;
    el.textContent = t;
    if(atBottom) el.scrollTop = el.scrollHeight;
  });
}
function maintOff(){
  if(!confirm('End maintenance mode and sleep?')) return;
  fetch('/maint/off', {method:'POST'}).then(()=>{
    document.getElementById('log').textContent =
      'Maintenance ended. Device will sleep shortly.\nYou can close this tab.';
  });
}
setInterval(refresh, 2000);
window.onload = refresh;
</script>
</head><body>
<div class="top">
  <h1>Bike-Mate Serial</h1>
  <button onclick="maintOff()">End Maintenance</button>
</div>
<div id="log">loading...</div>
</body></html>)rawliteral";
  server.send(200, "text/html", html);
}

static void handleSerialRaw() {
  server.send(200, "text/plain", serialBufGet());
}

static bool otaStarted = false;

// V5.09: per-64 KB progress for the serial monitor
static uint32_t _otaBytes = 0;
static uint32_t _otaLastLoggedKB = 0;

void _otaBlockReset() {
  _otaBytes = 0;
  _otaLastLoggedKB = 0;
}


static void handleOtaUpload() {
  HTTPUpload& upload = server.upload();
  if (upload.status == UPLOAD_FILE_START) {
    tprint("[OTA] start %s", upload.filename.c_str());
    otaStarted = false;
    // V4.88: drive the same OLED state the BLE OTA path used, so
    // the display shows Downloading -> Flashing -> Rebooting.
    extern volatile bool otaRequest;
    extern volatile uint8_t  otaStage;
    extern volatile uint32_t otaProgressBytes;
    extern volatile uint32_t otaProgressTotal;
    extern char otaVersion[16];
    otaRequest = true;
    otaStage = OTA_STAGE_DOWNLOAD;
    otaProgressBytes = 0;
    // V5.09: reset block logger. We can't reset the static in the
    // write branch from here directly, so use a sentinel value that
    // the write branch checks. Simpler: rely on otaProgressBytes
    // reset and reset the local counters via a file-scope variable.
    extern void _otaBlockReset();
    _otaBlockReset();
    otaProgressTotal = 0;
    // V4.90: read Content-Length so /ota-progress has a total.
    {
      String cl = server.header("Content-Length");
      if (cl.length() > 0) {
        otaProgressTotal = (uint32_t)cl.toInt();
      }
    }
    // V4.90: GUI passes target version as ?ver=X.YZ so the OLED can
    // show it. HTTP OTA has no other source for the incoming version.
    if (server.hasArg("ver")) {
      String v = server.arg("ver");
      strncpy(otaVersion, v.c_str(), 15);
      otaVersion[15] = 0;
      tprint("[OTA] target ver=%s", otaVersion);
    } else {
      otaVersion[0] = 0;
    }
    if (!Update.begin(UPDATE_SIZE_UNKNOWN)) {
      tprint("[OTA] begin FAILED: %s", Update.errorString());
      otaRequest = false;
    } else {
      otaStarted = true;
    }
  } else if (upload.status == UPLOAD_FILE_WRITE) {
    if (otaStarted) {
      if (Update.write(upload.buf, upload.currentSize) != upload.currentSize) {
        tprint("[OTA] write FAILED: %s", Update.errorString());
        otaStarted = false;
        extern volatile bool otaRequest;
        otaRequest = false;
      } else {
        extern volatile uint32_t otaProgressBytes;
        otaProgressBytes += upload.currentSize;
        // V5.09: log block progress every 64 KB so the serial monitor
        // shows the rate during upload. Matches Fan-Mate's granularity
        // candidate for parity — costs nothing, makes the 33 s vs 11 s
        // question answerable.
        _otaBytes += upload.currentSize;
        if (_otaBytes - _otaLastLoggedKB >= 65536) {
          _otaLastLoggedKB = _otaBytes;
          tprint_verbose("[OTA] %lu KB", (unsigned long)(_otaBytes / 1024));
          // V5.27: force OLED redraw during OTA. The maint loop is
          // blocked inside serverLoop() for the whole POST, so its
          // 1 Hz drawOLED() never fires until the upload finishes.
          // This gives ~1 Hz updates (~28 across a 1.8 MB binary).
          drawOLED();
        }
      }
    }
  } else if (upload.status == UPLOAD_FILE_END) {
    if (otaStarted) {
      if (Update.end(true)) {
        tprint("[OTA] OK %u bytes", upload.totalSize);
        extern volatile uint8_t otaStage;
        otaStage = OTA_STAGE_FLASH;
      } else {
        tprint("[OTA] end FAILED: %s", Update.errorString());
        extern volatile bool otaRequest;
        otaRequest = false;
      }
    }
  }
}

static void handleOtaDone() {
  if (Update.hasError()) {
    extern volatile bool otaRequest;
    otaRequest = false;
    server.send(500, "text/plain",
                "FAIL: " + String(Update.errorString()));
  } else {

    // V4.83: set NVS flag so the next boot forces maintenance mode.
    // HTTP OTA bypasses OtaManager.cpp entirely, so the flag has to be
    // set here.
    Preferences prefs;
    prefs.begin("ota", false);
    prefs.putBool("pending", true);
    bool verifyPending = prefs.getBool("pending", false);
    prefs.end();
    tprint("[OTA] NVS verify pending=%d", verifyPending ? 1 : 0);
    delay(200);

    server.send(200, "text/plain", "OK, rebooting");
    delay(200);

    // V4.88: show "Rebooting in Ns" on the OLED before reset.
    extern volatile uint8_t otaStage;
    extern volatile uint8_t otaRebootCountdown;
    otaStage = OTA_STAGE_REBOOT;
    for (int i = 5; i > 0; i--) {
      otaRebootCountdown = (uint8_t)i;
      tprint_verbose("[OTA] reboot in %d...", i);
      drawOLED();
      delay(1000);
    }

    display.clearDisplay();
    display.display();
    display.ssd1306_command(SSD1306_DISPLAYOFF);

    // V5.54: save the clock before resetting.
    extern void clockSave();
    clockSave();

    ESP.restart();
  }
}

static void handleOtaProgress() {
  extern volatile uint8_t  otaStage;
  extern volatile uint32_t otaProgressBytes;
  extern volatile uint32_t otaProgressTotal;
  extern volatile uint8_t  otaRebootCountdown;
  char buf[128];
  snprintf(buf, sizeof(buf),
           "{\"stage\":%u,\"bytes\":%lu,\"total\":%lu,\"countdown\":%u}",
           (unsigned)otaStage,
           (unsigned long)otaProgressBytes,
           (unsigned long)otaProgressTotal,
           (unsigned)otaRebootCountdown);
  server.send(200, "application/json", buf);
}

static void handleSettingsGet() {
  // V5.32: 128 bytes truncated the sleep+upload block. Full payload
  // is ~156 chars. 256 leaves room for future fields.
  char buf[256];
  size_t n = settingsToJson(buf, sizeof(buf));
  if (n >= sizeof(buf)) {
    tprint("[SETTINGS] JSON truncated: need %u, have %u",
           (unsigned)n, (unsigned)sizeof(buf));
  }
  server.send(200, "application/json", buf);
}

static void handleSettingsPost() {
  if (!server.hasArg("plain")) {
    server.send(400, "text/plain", "reject: no body");
    return;
  }
  if (settingsApplyJson(server.arg("plain").c_str())) {
    server.send(200, "text/plain", "OK");
  } else {
    server.send(400, "text/plain", "reject: see serial log");
  }
}

static void handleVersion() {
  server.send(200, "text/plain", BIKE_MATE_VERSION);
}

static void handleClockPost() {
  // V5.22: set clock over HTTP during maint. Accepts either
  // a decimal epoch string or 4 raw little-endian bytes.
  extern uint32_t macTimeEpoch;
  extern uint32_t secondsAtSync;
  extern uint32_t totalSeconds;
  if (!server.hasArg("plain")) {
    server.send(400, "text/plain", "reject: no body");
    return;
  }
  String body = server.arg("plain");
  uint32_t e = 0;
  if (body.length() == 4) {
    memcpy(&e, body.c_str(), 4);
  } else {
    e = (uint32_t)strtoul(body.c_str(), NULL, 10);
  }
  if (e < 1700000000UL || e > 4102444800UL) {
    tprint("[CLOCK] /clock reject epoch=%lu", (unsigned long)e);
    server.send(400, "text/plain", "reject: epoch out of range");
    return;
  }
  struct timeval tv = { .tv_sec = (time_t)e, .tv_usec = 0 };
  settimeofday(&tv, NULL);
  tprint("[CLOCK] set via HTTP epoch=%lu", (unsigned long)e);
  server.send(200, "text/plain", "OK");
}

volatile bool uploadNowRequested = false;
volatile int accOverride = -1; // -1 = auto, 0 = force off, 1 = force on

static void handleUploadNow() {
  uploadNowRequested = true;
  tprint("[UPLOAD] /upload requested");
  server.send(200, "text/plain", "OK");
}

static void handleSeal() {
  // V5.28: manual seal. Wake file always. Ride file if logging.
  extern bool isLogging;
  uint32_t ep = currentEpoch();
  if (ep == 0) {
    server.send(500, "text/plain", "no clock");
    return;
  }
  tprint("[SEAL] manual seal requested");
  bool wakeOk = wakeLoggerSealManual(ep);
  bool rideOk = true;
  if (isLogging) {
    tprint("[SEAL] ride in progress, closing");
    extern void closeRideLog(bool stall = false, uint32_t stallDur = 0);
    closeRideLog(false, 0);
  }
  server.send(200, "text/plain",
              wakeOk && rideOk ? "OK" : "PARTIAL");
}

static void handleMaintOff() {
  maintOffRequested = true;
  tprint("[MAINT] /maint/off received");
  server.send(200, "text/plain", "OK");
}

void serverSetup() {
  if (running) return;
  server.on("/serial",     HTTP_GET,  handleSerialPage);
  server.on("/serial-raw", HTTP_GET,  handleSerialRaw);
  server.on("/maint/off",  HTTP_POST, handleMaintOff);
  server.on("/upload",     HTTP_POST, handleUploadNow);
  server.on("/acc",        HTTP_POST, []() {
    if (server.hasArg("plain")) {
      String b = server.arg("plain");
      if (b == "on" || b == "1") accOverride = 1;
      else if (b == "off" || b == "0") accOverride = 0;
      else accOverride = -1;
      server.send(200, "text/plain", "OK");
    } else {
      server.send(400, "text/plain", "reject: no body");
    }
  });
  server.on("/seal",       HTTP_POST, handleSeal);
  server.on("/ota",        HTTP_POST, handleOtaDone, handleOtaUpload);
  server.on("/version",    HTTP_GET,  handleVersion);
  server.on("/clock",      HTTP_POST, handleClockPost);
  server.on("/settings",   HTTP_GET,  handleSettingsGet);
  server.on("/settings",   HTTP_POST, handleSettingsPost);
  server.on("/ota-progress", HTTP_GET, handleOtaProgress);
  server.onNotFound([](){ server.send(404, "text/plain", "404"); });
  server.begin();
  running = true;
  tprint("[HTTP] server up on :80");
}

void serverLoop() {
  if (!running) return;
  server.handleClient();
}

void serverStop() {
  if (!running) return;
  server.stop();
  running = false;
  tprint("[HTTP] server down");
}

bool serverIsRunning() { return running; }
