bigbadevilaussie-hue/Bike-Mate/WifiManager.cpp

// WifiManager.cpp — BIKE-MATE V3.60
// WiFi bring-up using the proven IDF sequence from the diagnostic.
// V3.60: force SSID/password from Config.h (override stale NVS cache).
// V3.34: IDF teardown + re-init, 20 dBm, BSSID clear, PMF optional.
// V3.32: NTP failure fails bring-up.

#include "WifiManager.h"
#include "BleManager.h"

#include <WiFi.h>
#include <HTTPClient.h>
#include <WiFiClient.h>
#include <esp_wifi.h>
#include <time.h>

extern void tprint(const char* fmt, ...);
extern void tprint_verbose(const char* fmt, ...);
extern uint32_t macTimeEpoch;
extern uint32_t secondsAtSync;
extern uint32_t totalSeconds;
extern uint32_t currentEpoch();   // V5.63

char wifiMessage[24] = "";

static volatile uint32_t wifiLastEvent = 0;
static volatile uint32_t wifiLastDisconnectReason = 0;
static volatile int8_t wifiLastDisconnectRssi = 0;
static volatile uint32_t wifiEventCount = 0;

static void wifiDebugEvent(WiFiEvent_t event, WiFiEventInfo_t info) {
  wifiLastEvent = (uint32_t)event;
  wifiEventCount++;

  switch (event) {
    case ARDUINO_EVENT_WIFI_READY:
      tprint_verbose("[WIFI-EVENT] READY");
      break;

    case ARDUINO_EVENT_WIFI_STA_START:
      tprint_verbose("[WIFI-EVENT] STA_START");
      break;

    case ARDUINO_EVENT_WIFI_STA_CONNECTED: {
      char bssid[18];
      snprintf(bssid, sizeof(bssid),
               "%02X:%02X:%02X:%02X:%02X:%02X",
               info.wifi_sta_connected.bssid[0],
               info.wifi_sta_connected.bssid[1],
               info.wifi_sta_connected.bssid[2],
               info.wifi_sta_connected.bssid[3],
               info.wifi_sta_connected.bssid[4],
               info.wifi_sta_connected.bssid[5]);

      tprint("[WIFI-EVENT] STA_CONNECTED bssid=%s channel=%u",
             bssid,
             (unsigned)info.wifi_sta_connected.channel);
      break;
    }

    case ARDUINO_EVENT_WIFI_STA_DISCONNECTED:
      wifiLastDisconnectReason =
          (uint32_t)info.wifi_sta_disconnected.reason;
      wifiLastDisconnectRssi =
          info.wifi_sta_disconnected.rssi;

      tprint("[WIFI-EVENT] STA_DISCONNECTED reason=%u rssi=%d",
             (unsigned)info.wifi_sta_disconnected.reason,
             (int)info.wifi_sta_disconnected.rssi);

      tprint("[WIFI-EVENT] disconnect ssid='%.*s'",
             info.wifi_sta_disconnected.ssid_len,
             info.wifi_sta_disconnected.ssid);

      tprint("[WIFI-EVENT] bssid=%02X:%02X:%02X:%02X:%02X:%02X",
             info.wifi_sta_disconnected.bssid[0],
             info.wifi_sta_disconnected.bssid[1],
             info.wifi_sta_disconnected.bssid[2],
             info.wifi_sta_disconnected.bssid[3],
             info.wifi_sta_disconnected.bssid[4],
             info.wifi_sta_disconnected.bssid[5]);
      break;

    case ARDUINO_EVENT_WIFI_STA_GOT_IP:
      tprint("[WIFI-EVENT] GOT_IP ip=%s mask=%s gw=%s",
             WiFi.localIP().toString().c_str(),
             WiFi.subnetMask().toString().c_str(),
             WiFi.gatewayIP().toString().c_str());
      break;

    case ARDUINO_EVENT_WIFI_STA_LOST_IP:
      tprint_verbose("[WIFI-EVENT] LOST_IP");
      break;

    case ARDUINO_EVENT_WIFI_STA_STOP:
      tprint_verbose("[WIFI-EVENT] STA_STOP");
      break;

    default:
      tprint("[WIFI-EVENT] event=%d", (int)event);
      break;
  }
}

static void setMsg(const char* m) {
  snprintf(wifiMessage, sizeof(wifiMessage), "%s", m);
}

// V5.08: ping the LAN gateway, not the internet. Maint and the
// clock fetch only need LAN reachability. On a bad-uplink day the
// internet ping can take 15+ seconds (jitter + TCP retries), which
// delays maint entry for no reason. LAN round-trip is ~5 ms.
bool wifiPingTest() {
  IPAddress gw = WiFi.gatewayIP();
  if ((uint32_t)gw == 0) return false;
  // V5.53: retry the LAN probe. The first TCP connect after a flaky
  // association often fails because the ARP cache is cold. Retrying
  // warms it. Three attempts, 400 ms apart.
  for (int attempt = 1; attempt <= 4; attempt++) {
    WiFiClient test;
    bool ok = test.connect(gw, 80, 2000);   // V5.54: ms connect timeout
    test.stop();
    if (ok) {
      if (attempt > 1) {
        tprint("[WIFI] ping OK on attempt %d", attempt);
      }
      return true;
    }
    if (attempt < 4) delay(3000);   // V5.55: longer settle after post-reset association
  }
  return false;
}

// V4.92: fetch the router's Date header over LAN. The Opal
// (GL-SFT1200) is always up — even when the phone uplink is gone — so
// its clock is the fastest and most reliable source on the network.
// LAN RTT is ~5 ms, vs 60-100 ms for internet NTP. Falls back to NTP
// if this fails.
// V5.00: timegm() is not exposed by the ESP32 newlib headers.
// Convert a UTC struct tm to a Unix epoch manually. Standard
// days-from-civil algorithm (Howard Hinnant).
static time_t _utcToEpoch(int year, int mon, int day,
                          int hour, int min, int sec) {
  int y = year;
  unsigned m = (unsigned)mon;
  unsigned d = (unsigned)day;
  y -= m <= 2;
  const int era = (y >= 0 ? y : y - 399) / 400;
  const unsigned yoe = (unsigned)(y - era * 400);
  const unsigned doy = (153 * (m + (m > 2 ? -3 : 9)) + 2) / 5 + d - 1;
  const unsigned doe = yoe * 365 + yoe / 4 - yoe / 100 + doy;
  const long long days = (long long)era * 146097LL + (long long)doe - 719468LL;
  return (time_t)(days * 86400LL + hour * 3600LL + min * 60LL + sec);
}

static bool opalClockSync() {
  IPAddress gw = WiFi.gatewayIP();
  if ((uint32_t)gw == 0) {
    tprint("[CLOCK] no gateway");
    return false;
  }
  char url[48];
  snprintf(url, sizeof(url), "http://%u.%u.%u.%u/",
           (unsigned)gw[0], (unsigned)gw[1],
           (unsigned)gw[2], (unsigned)gw[3]);
  tprint("[CLOCK] querying %s", url);

  HTTPClient http;
  http.setTimeout(3000);
  http.setConnectTimeout(3000);   // V5.54: separate connect timeout
  http.setReuse(false);
  if (!http.begin(url)) {
    tprint("[CLOCK] begin failed");
    return false;
  }
  const char* hdrs[] = { "Date" };
  http.collectHeaders(hdrs, 1);

  // V5.55: ping before the first GET. The post-OTA window is flaky;
  // the gateway becomes reachable a second before the first HTTP GET
  // would have timed out.
  wifiPingTest();

  int code = http.GET();
  if (code <= 0) {
    tprint("[CLOCK] Opal GET code=%d, retry in 4s", code);
    http.end();
    delay(4000);
    wifiPingTest();   // V5.55: warm the ARP before the retry
    if (!http.begin(url)) {
      tprint("[CLOCK] retry begin failed");
      return false;
    }
    http.collectHeaders(hdrs, 1);
    code = http.GET();
    tprint("[CLOCK] retry code=%d", code);
  }
  tprint_verbose("[CLOCK] HTTP code=%d", code);
  bool ok = false;
  if (code > 0) {
    String d = http.header("Date");
    if (d.length() > 0) {
      // "Tue, 06 Oct 2026 07:33:19 GMT"
      struct tm tmv = {};
      if (strptime(d.c_str(), "%a, %d %b %Y %H:%M:%S GMT", &tmv)) {
        time_t t = _utcToEpoch(
            tmv.tm_year + 1900, tmv.tm_mon + 1, tmv.tm_mday,
            tmv.tm_hour, tmv.tm_min, tmv.tm_sec);
        if (t > 1700000000) {
          struct timeval tv = { .tv_sec = t, .tv_usec = 0 };
          settimeofday(&tv, NULL);
          tprint("[CLOCK] Opal Date=%s -> %lu",
                 d.c_str(), (unsigned long)t);
          setMsg("Clock OK");
          ok = true;
        } else {
          tprint("[CLOCK] Opal time out of range: %lu", (unsigned long)t);
        }
      } else {
        tprint("[CLOCK] Date parse failed: %s", d.c_str());
      }
    } else {
      tprint("[CLOCK] no Date header (code=%d)", code);
    }
  } else {
    tprint("[CLOCK] HTTP GET failed: %d", code);
  }
  http.end();
  return ok;
}

static bool ntpSync() {
  setMsg("NTP sync");
  tprint("[WIFI] NTP sync");

  // V5.63: don't let NTP overwrite a plausible clock. A bad NTP
  // response was stamping 2038-01-02 and renaming wake files
  // wakes_2038-01-02.csv.
  uint32_t known = currentEpoch();
  if (known >= 1700000000UL && known <= 1893456000UL) {
    tprint("[WIFI] NTP skipped, clock already valid (%lu)",
           (unsigned long)known);
    setMsg("Clock ok");
    return true;
  }

  configTime(0, 0, "pool.ntp.org", "time.nist.gov");
  unsigned long t0 = millis();
  time_t now = 0;
  while (millis() - t0 < 20000UL) {
    time(&now);
    if (now > 1700000000) {
      uint32_t now32 = (uint32_t)now;
      if (known > 1700000000UL) {
        long diff = (long)now32 - (long)known;
        if (diff < 0) diff = -diff;
        if (diff > 31536000L) {
          tprint("[WIFI] NTP rejected: %lu vs known %lu (off %lds)",
                 (unsigned long)now32, (unsigned long)known, diff);
          setMsg("NTP reject");
          return false;
        }
      }
      struct timeval tv = { .tv_sec = now32, .tv_usec = 0 };
      settimeofday(&tv, NULL);
      tprint("[WIFI] NTP OK %lu", (unsigned long)now32);
      setMsg("NTP OK");
      return true;
    }
    delay(500);
  }
  tprint("[WIFI] NTP timeout");
  setMsg("NTP fail");
  return false;
}

static bool _wifiBringUpOnce(unsigned long perAttemptTimeoutMs) {
  tprint("[WIFI] bring-up start");

  bleStop();
  delay(800);

  // V3.34: full IDF teardown + re-init (proven 72/72 on Opal)
  esp_wifi_stop();
  esp_wifi_deinit();
  delay(300);

  WiFi.mode(WIFI_STA);
  delay(100);

  wifi_init_config_t cfg = WIFI_INIT_CONFIG_DEFAULT();
  esp_wifi_init(&cfg);
  esp_wifi_start();
  delay(100);

  // TX power 8.5 dBm (raw 34) — proven on both boards
  esp_wifi_set_max_tx_power(34);

  // V3.60: force SSID + password, clear BSSID, PMF optional
  {
    wifi_config_t wc = {};
    esp_wifi_get_config(WIFI_IF_STA, &wc);

    memset(wc.sta.ssid, 0, sizeof(wc.sta.ssid));
    memset(wc.sta.password, 0, sizeof(wc.sta.password));
    strncpy((char*)wc.sta.ssid, WIFI_SSID, sizeof(wc.sta.ssid) - 1);
    strncpy((char*)wc.sta.password, WIFI_PASSWORD, sizeof(wc.sta.password) - 1);

    memset(wc.sta.bssid, 0, 6);
    wc.sta.bssid_set = 0;
    wc.sta.pmf_cfg.required = false;

    esp_wifi_set_config(WIFI_IF_STA, &wc);
  }

  // Static IP: reserved on Opal for Bike-Mate MAC AC:27:6E:26:0B:90
  IPAddress staticIP(192, 168, 8, 196);
  IPAddress gateway(192, 168, 8, 1);
  IPAddress subnet(255, 255, 255, 0);
  IPAddress dns(192, 168, 8, 1);
  WiFi.config(staticIP, gateway, subnet, dns);

  tprint("[WIFI] static IP %s gw=%s",
         staticIP.toString().c_str(),
         gateway.toString().c_str());

  setMsg("Connecting");
  tprint("[WIFI] connecting to '%s'", WIFI_SSID);
  esp_err_t connErr = esp_wifi_connect();
  tprint("[WIFI] esp_wifi_connect = 0x%08X", connErr);

  unsigned long t0 = millis();
  unsigned long lastIpDiag = 0;
  while (WiFi.status() != WL_CONNECTED) {
    if (millis() - lastIpDiag >= 2000UL) {
      lastIpDiag = millis();
      tprint("[WIFI-IP] status=%d ip=%s mask=%s gw=%s",
             WiFi.status(),
             WiFi.localIP().toString().c_str(),
             WiFi.subnetMask().toString().c_str(),
             WiFi.gatewayIP().toString().c_str());
    }

    if (millis() - t0 > perAttemptTimeoutMs) {
      tprint("[WIFI] timeout after %lu ms (status=%d)",
             (unsigned long)perAttemptTimeoutMs, WiFi.status());
      WiFi.disconnect(true);
      WiFi.mode(WIFI_OFF);
      setMsg("WiFi fail");
      return false;
    }
    delay(400);
  }

  tprint_verbose("[WIFI] OK %s", WiFi.localIP().toString().c_str());
  tprint("[WIFI] RSSI %d dBm", WiFi.RSSI());
  setMsg("Connected");

  // V5.62: ping is advisory, not fatal. The association succeeded,
  // the IP is assigned, the LAN is up. A single TCP connect to the
  // gateway failing does not mean the LAN is down. Previously this
  // killed the whole bring-up on the first failure, causing the
  // rapid assoc/deassoc churn the Opal's log showed. Now we log it
  // and continue. If the Opal really is unreachable, the clock
  // fetch and any upload will fail at a later, more useful point.
  if (!wifiPingTest()) {
    tprint("[WIFI] ping FAIL (advisory, continuing)");
    setMsg("Ping warn");
  } else {
    tprint("[WIFI] ping OK");
    setMsg("Ping OK");
  }

  // V5.07: clock fetch moved OUT of the critical path. The Opal's
  // uhttpd can stall for 3+ seconds under LuCI load, and NTP can
  // take 8+ seconds. Neither is required for the HTTP server to
  // start. The caller runs clockBringUp() after serverSetup() so
  // maint entry is not gated on clock acquisition.
  return true;
}

// V4.91: retry wrapper. On the C3 (core 2.0.17, bad antenna) WiFi
// bring-up after an active BLE session fails intermittently — the
// association never progresses and status stays WL_IDLE_STATUS. A
// second attempt after a full teardown + settle usually succeeds.
// Two attempts total, then give up (bike sleeps, retries next wake).
bool wifiBringUp(unsigned long perAttemptTimeoutMs) {
  // V5.34: register the event handler once. On core 2.0.17 WiFi.onEvent
  // stacks handlers rather than replacing, so calling this on every
  // bring-up caused duplicate [WIFI-EVENT] logs.
  static bool _evtRegistered = false;
  if (!_evtRegistered) {
    WiFi.onEvent(wifiDebugEvent);
    _evtRegistered = true;
  }
  for (int attempt = 1; attempt <= 2; attempt++) {
    tprint("[WIFI] attempt %d/2", attempt);
    if (_wifiBringUpOnce(perAttemptTimeoutMs)) {
      return true;
    }
    if (attempt < 2) {
      tprint("[WIFI] attempt %d failed, settling 3s before retry", attempt);
      WiFi.disconnect(true);
      WiFi.mode(WIFI_OFF);
      delay(3000);
    }
  }
  tprint("[WIFI] all attempts failed");
  return false;
}

// V5.07: called after serverSetup(). Not on the maint-entry
// critical path. Tries Opal LAN first (fast), falls back to NTP.
// Failure is non-fatal — the bike keeps its RTC value.
void clockBringUp() {
  if (opalClockSync()) {
    tprint("[CLOCK] from LAN");
    return;
  }
  if (ntpSync()) {
    tprint("[CLOCK] from NTP");
    return;
  }
  tprint("[CLOCK] no source, keeping RTC");
}

void wifiBringDown() {
  WiFi.disconnect(true);
  WiFi.mode(WIFI_OFF);
  setMsg("");
  tprint("[WIFI] down");
  bleStart();
}
