bigbadevilaussie-hue/Bike-Mate/(commit log)

2026-09-23 V4.12: real NTC temp, ADC calibration fixes, remove 0.913 correction
    [Config.h, Sensors.cpp, Sensors.h, bike_mate.ino]
2026-09-23 V4.16: NTC calibrated, SDA GPIO 6, readSensors in loop, SENSOR debug
2026-10-01 Add AUDIT.md — consolidated peer review from 4 AI reviewers
2026-10-01 Add TODO.md — ranked by verifiability, not AI consensus
2026-10-01 Rewrite docs to match V4.21 reality — reference AUDIT.md and TODO.md
2026-10-01 Update BENCH.md — traced circuit, hardware TODO, board notes
2026-10-01 V4.24: version bump + GUI lambda closure fixes
    [Config.h]
2026-10-01 Add NEXT_SESSION.md — handoff context for next AI
2026-10-01 Keep [SET-DBG] prints for BLE troubleshooting
2026-10-01 V4.31.1: rename device to Bike-Mate-2 to bust macOS BLE cache
2026-10-01 GUI: reports submenu — Last Day / Last Ride / Last Week
2026-10-01 V4.34: safety batch + IP OTA + MD5-revert + GUI 3.14
    [Config.h, DriveUpload.cpp, OtaManager.cpp, WifiMail.cpp]
2026-10-01 V4.36: NTC revert to V4.34 values, docs sync
    [Config.h, DisplayManager.cpp, Sensors.cpp, bike_mate.ino]
2026-10-02 BENCH: Section 6 switched rail built, TODO checked off
2026-10-02 V4.42: wake log pauses during rides, 5s ride cadence, real state in wake log, RTC wake-overhead fix, Rule 7 debug, GUI Reports submenu + theme system
    [Config.h, DriveUpload.cpp, WakeLogger.cpp, bike_mate.ino]
2026-10-02 V4.43: ADC mux settle read, settings+report theming
2026-10-02 V4.46: GPS module, OLED speed, ride pause/resume, RTC persistence, ADC settle
2026-10-02 V4.50: strict GPS fix (4+ sats), state-driven flags
    [Config.h, GpsModule.cpp]
2026-10-02 V4.53.Panic: wake-only PANIC latch (day 3/night 4), cold boot reset, low-batt alert latch, state codes 0-4
    [Config.h, DriveUpload.cpp, WakeLogger.cpp, bike_mate.ino]
2026-10-04 V4.56: dual upload skip path fix, OTA server restart
    [Config.h, DriveUpload.cpp, bike_mate.ino]
2026-10-05 V4.61: engine-start capture millis() wraparound fix
    [Config.h, bike_mate.ino]
2026-10-05 V4.72: PANIC wakes, beeps, mails, sleeps — max-awake timeout, no more death spiral
2026-10-05 V4.73: BLE hard timeout, seal cleanup after LittleFS mount, BENCH_MODE 0, PANIC beep once-per-wake
2026-10-05 V4.75: maintenance mode — serial page over HTTP, safety timeout, BLE trigger
2026-10-05 V4.78: HTTP OTA route (/ota) + /version, GUI 4.15 uses /version for device ver during maint
2026-10-05 V4.84: idle BLE connection does not block sleep — track last incoming write, 5 s grace
2026-10-06 V4.86: bleStop waits for BT controller idle before WiFi bring-up
    V4.84 made the BLE link sticky (idle grace window), which exposed a
    latent race in bleStop(): it returned before the shared radio was
    actually released. WiFi bring-up then tore down and re-inited the
    driver while BT was mid-teardown, leaving the WiFi stack in
    WL_IDLE_STATUS — connect returned OK but association never progressed.
    bleStop() now polls esp_bt_controller_get_status() until idle or
    inited, bounded at 2 s, then settles 200 ms.
    Confirmed end-to-end: maint entry reaches [WIFI] OK and
    [MAINT] active on first wake cycle, HTTP OTA completes, post-OTA
    cold boot auto re-enters maint.
2026-10-06 V4.91: maint mode end-to-end — OLED, engine bail, retry, OTA progress
    Firmware:
    - Maint loop keeps the OLED lit and bails on engine start. Screen now
    shows MAINT / MODE / wifiMessage / Ns left.
    - HTTP OTA drives the existing OLED OTA screen (Downloading / Flashing /
    Rebooting N) with a 5..1 countdown before reset.
    - Skip bleInit() when maintRequest is set at setup() for a clean radio.
    - wifiBringUp() retry wrapper: 2 attempts with 3 s settle, masks the
    intermittent C3 + 2.0.17 association failure after an active BLE session.
    - /ota-progress endpoint (stage/bytes/total/countdown).
    - otaVersion read from ?ver= query param.
    - Guard hard-exempt when isLogging || engineWasRunning || accSt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
    [Config.h, DisplayManager.cpp, WebServer.cpp, WifiManager.cpp, bike_mate.ino]
2026-10-06 docs: reconcile README, PROJECT_STATE, FILES, HANDOFF, MAINTENANCE, TODO
    Version sweep: firmware 4.91, GUI 4.24. Fixes stale claims and adds
    V4.86-4.91 behaviour to the docs.
    README / PROJECT_STATE / HANDOFF / FILES:
    - /ota-progress endpoint documented
    - maint entry now described as: maint-bound wake skips BLE entirely,
    wifiBringUp() retries twice, OLED stays lit, sensors sampled at 500 ms
    - maint exit via engine-start bail documented alongside /maint/off and
    the 15-min cap
    - OTA now POSTs to /ota?ver=X.YZ; GUI polls /ota-progress for stage
    transitions. Noted limitation: Arduino WebServer strips Content-Length
    on multipart upload, so percent complete is not available.
    - drawMaintScr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
2026-10-06 V5.00: LAN clock from Opal router, NTP demoted to fallback, hard gate removed
    The Opal (GL-SFT1200) is always up — even with no upstream carrier.
    Its HTTP Date header is accurate and reachable from the bike's subnet
    in ~5 ms LAN RTT, vs 60-100 ms for internet NTP and up to 30 s on a
    mobile carrier that throttles UDP 123.
    wifiBringUp() now:
    1. associate
    2. ping
    3. fetch http://<gateway>/ and parse the Date header (opalClockSync)
    4. fall back to NTP only if the Opal call fails
    5. continue with a stale clock if both fail (was: hard fail)
    The NTP hard gate is removed. maint, upload, and OTA no longer depend
    on internet NTP being reachable.
    Implementation notes:
    - timegm() is not e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
    [Config.h, WifiManager.cpp]
2026-10-06 V5.01: log HTTP status in opalClockSync for diagnosability
    Fan-Mate just spent a cycle chasing an empty Date header that turned
    out to be a HEAD-vs-GET issue. Without a logged status code, that took
    several iterations to spot. One extra log line makes the same failure
    obvious on the next occurrence.
    Also confirmed in this build: LAN clock fetch on the C3 completes in
    ~150 ms from HTTP GET to clock-set. The earlier 2.7 s was an outlier,
    likely the Opal's HTTP server mid-housekeeping (the same 150-225 ms
    spikes Fan-Mate saw in their Mac tests).
    Verified on hardware: cold boot -> maint -> Opal clock in 150 ms ->
    HTTP server up in 4.9 s total. Bounded worst case, no more NTP tail.
    [Config.h, WifiManager.cpp]
2026-10-06 V5.03: settings schema refactor — RUN MODE / MONITOR MODE
    Schema:
    RUN MODE: runningEnter, runningExit, runUnder, runOver
    MONITOR MODE: monitorNormal, monitorWarning, monitorPanic
    Seven settings, all runtime-tunable in NVS bikeset namespace. Old flat
    voltage dict (running_enter / running_exit / under_run) replaced.
    Fixes the under-volt false flag: runUnder now defaults to 13000
    (matches runningExit) instead of 13800 (which duplicated runningEnter
    and flagged every ride close).
    The four Config.h threshold defines are gone:
    V_PANIC_ENTER, V_PANIC_EXIT, WARN_EMAIL_VOLTAGE, WARN_RECOVER_VOLTAGE
    Recovery values derived: panic exit = panic + 200 mV, warn recover =
    warning + 200 mV. V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
    [Config.h, RideLogger.cpp, Settings.cpp, Settings.h, bike_mate.ino]
2026-10-06 bikemate: insert module markers for extraction
    No behaviour change. 18 marker pairs delineating extraction blocks.
    Next: strip script will pull each marked block into bikemate/*.py.
2026-10-06 bikemate: modular split — package layout
    Split the 2169-line monolith into a package:
    bikemate/
    __init__.py
    config.py — constants, themes, UUIDs, IPs, timeouts
    state.py — mutable globals, deques, locks
    helpers.py — small utility funcs, time/emoji helpers
    weather.py — weather fetch + background loop
    widgets.py — Graph
    ota.py — HTTP OTA servers
    drive.py — Drive sync + backup + local server
    ble.py — BLEWorker
    reports.py — BikeReport, LastRideReport, WaitingForRide
    app.py — App class (menu, tick, main window)
    bikemate.py is now a 10-line launcher.
    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
2026-10-06 GUI 4.29: maint pending countdown + bike day/night boundaries
    state.py:
    maint_pending_since, maint_pending_timeout
    helpers.py:
    is_bike_daytime() — firmware's 22:00-04:00 night window, separate
    from the GUI's 18:00-06:00 theme window
    expected_wake_seconds() — 300 day / 600 night
    pending_timeout_seconds() — wake interval + 2 min margin
    config.py:
    BIKE_NIGHT_START_HOUR = 22
    BIKE_NIGHT_END_HOUR = 4
    app.py:
    activate_maintenance() records start time and timeout
    _start_maint_poll() uses the stored timer, no local start
    tick() shows 'MAINT PENDING M:SS (bike asleep)' with countdown
    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
2026-10-06 V5.06: static IP eliminates intermittent post-association DHCP failure
    Root cause of the ~50% maintenance-entry failure identified:
    STA_CONNECTED at RSSI -44 to -54 (association always succeeds)
    status=0, ip=0.0.0.0 for 14-30 seconds
    no GOT_IP
    timeout after 30s -> STA_DISCONNECTED reason=8
    retry sometimes succeeds
    This is a DHCP acquisition failure, not a WiFi association failure.
    Association is a single handshake and always completes. DHCP is a
    four-round-trip flow and was taking variable time, sometimes exceeding
    the 30s per-attempt timeout.
    Fix: static IP configuration. DHCP disabled on the STA interface.
    The Opal has 192.168.8.196 reserved for Bike-Mate.
    IP: 192.168.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
    [Config.h, WifiManager.cpp]
2026-10-06 V5.07 + V5.08: same-wake maint entry, clock off critical path, LAN ping
    V5.07:
    - goToSleep() checks maintRequest before sleeping. The BLE callback
    runs on the BT stack task, so the flag can be set while the loop is
    already inside the sleep wait. Without the check, the bike slept
    with the flag set and consumed it on the next wake — the 'extra
    10 min wait' issue. Now: flag set → abort sleep → return to loop →
    maint block runs this wake.
    - clockBringUp() extracted from wifiBringUp(). Opal fetch and NTP
    fallback now run AFTER serverSetup(), not before. Maint entry is
    not gated on clock acquisition. On a slow-Opal day the server comes
    up immediately and the clock catches u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
    [Config.h, WifiManager.cpp, WifiManager.h, bike_mate.ino]
2026-10-07 GUI 4.32 + firmware fix: Fan-Mate-shaped OTA dialog, verified working
    Working tree as of 2026-10-07, verified on hardware. Firmware fix by
    GPT. GUI changes: OTA dialog shows File / Size / MD5 / Source ver /
    Built / Device ver, upload runs in a background worker, archives local
    .bin to ~/bike-mate-ota/firmware/, no progress window, no auto-backup
    to Drive, GUI_VERSION 4.32.
    [Config.h, WebServer.cpp]
2026-10-07 Config.h: 5.09 -> 5.08 to match running firmware
    bb338e9 bumped the source to 5.09 but the bench bike was never
    reflashed with that build. Revert to 5.08 so source and binary agree.
    The GUI 4.32 OTA dialog is unaffected.
    [Config.h]
2026-10-07 V5.16: GitHub Contents API replaces Apps Script; token from Config.local.h
    [Config.h, DriveUpload.cpp]
2026-10-07 docs: consolidate 8 docs into README
    Merged HANDOFF, PROJECT_STATE, FILES, TODO, AUDIT, BENCH, MAINTENANCE
    into a single README. Rules section at the bottom replaces HANDOFF's
    non-negotiable rules.
    Sections:
    - Prime directive + current state
    - Hardware + pin map
    - What it does
    - Firmware modules + HTTP endpoints
    - Maintenance mode (Opal clock, static IP, 8.5 dBm, coexistence)
    - GUI package layout
    - Bench snapshot (divider, NTC, OLED, buzzer, ACC, GPS)
    - Protected systems
    - Known open issues
    - Prime directive details
    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
2026-10-08 docs: DYNA_TUNE.md — post-ride diagnostics + settings history spec
2026-10-10 V5.23: force upload via HTTP /upload during maint
    - WebServer: /upload endpoint sets uploadNowRequested flag
    - bike_mate.ino: maint loop consumes flag, runs driveUploadPerform(true)
    - DriveUpload: bool fromMaint param, skip wifiBringDown when called from maint
    - BleManager: remove BLE force-upload handler
    - app.py: force_upload uses HTTP POST /upload; GUI 4.37
    - WakeLogger, Settings, WifiManager, OtaManager: tprint_verbose cleanups
    - README: zsh bracketed-paste note, patch anchor rules
    [Config.h, DriveUpload.cpp, DriveUpload.h, OtaManager.cpp, Settings.cpp, WakeLogger.cpp, WebServer.cpp, WebServer.h]
2026-10-10 V5.24: storage % telemetry, GUI 4.38 Stor badge, TODO refresh
    - BleManager.cpp: "st":<percent> in publishBLE JSON
    - bikemate/app.py: Stor column between Temp and Time, GUI 4.38
    - Config.h: 5.24
    - TODO.md: rewrite to match actual state; mark force-upload HTTP path done;
    add /clock BLE-clobber issue; add 4am test plan
    [BleManager.cpp, Config.h]
2026-10-10 V5.25: clock sync in driveUploadPerform, upload reason
    - DriveUpload.cpp: call clockBringUp() after wifiBringUp() so the
    4am scheduled path syncs the clock before sealing and uploading
    - DriveUpload.h/.cpp: add const char* reason param, printed in the
    ENTERING UPLOAD MODE line (forced / scheduled)
    - bike_mate.ino: maint consume passes "forced"; removed duplicate
    ENTERING UPLOAD MODE print from doStateWork upload block
    - Config.h: 5.25
2026-10-10 V5.26: GPS debug print — utc, hdg, alt
    - GpsModule.cpp/.h: parse GPRMC time (hhmmss) into _timeUTC, GPVTG
    course into _courseDeg. Add gpsTimeUTC() and gpsCourseDeg() accessors.
    - bike_mate.ino: extend the 5s [GPS] debug line with utc=%s hdg=%.1f
    alt=%.1f
    - Config.h: 5.26
2026-10-10 V5.27: ride header/footer stamps, gzip all, OTA OLED, debug heartbeats
    - RideStorage: # opened= header (was # ride_start=), # pre_ride_volt=,
    # start_loc=, # closed= footer via rideStorageLogClose
    - RideStorage.h: rideStorageCreate takes preRideVoltage
    - RideLogger: pass ridePreVoltage, call rideStorageLogClose before close
    - RideStorage.cpp / WakeLogger.cpp: gzip every file (threshold 1024 -> 0)
    - WebServer.cpp: drawOLED() during OTA progress
    - bike_mate.ino: debug heartbeats + per-stage timing markers
    - Config.h: 5.27.1
2026-10-10 V5.28: /seal endpoint, monotonic epoch floor
    - WebServer.cpp: POST /seal handler, calls wakeLoggerSealManual() and
    closes the ride if logging
    - WakeLogger.h/.cpp: wakeLoggerSealManual() — bypasses the .sealed-exists
    and _paused guards. Writes # closed=, seals, gzips, deletes raw, opens
    a fresh file. Manual override for maint.
    - bike_mate.ino: _epochFloor (RTC_DATA_ATTR) clamps currentEpoch() so it
    never returns a value lower than the highest already returned this
    session. Fixes out-of-order wake rows on the bench from BLE/Opal clock
    syncs pulling the clock backward.
    - Config.h: 5.28
    [Config.h, WakeLogger.cpp, WakeLogger.h, WebServer.cpp, bike_mate.ino]
2026-10-10 V5.30: upload routine cleanup
    - DriveUpload.cpp: reconcileLittleFS skips the currently-open wake and
    ride files. It was gzipping and deleting the fresh wake file the seal
    had just opened.
    - DriveUpload.cpp: postFile treats HTTP 422 as already-exists. GitHub
    returns 422 when the target path exists without a sha. For
    append-once diagnostic logs, the remote copy is presumed identical.
    - RideStorage.cpp: delete raw .csv after successful gzip in
    rideStorageClose. Source of the orphan .csv pile.
    - WakeLogger.cpp: delete raw .sealed after successful gzip in
    wakeLoggerForceRotate. Source of the orphan .sealed pile.
    - Config.h: 5.30
    [Config.h, DriveUpload.cpp, RideStorage.cpp, WakeLogger.cpp, WakeLogger.h]
2026-10-10 docs: trim README — compress hardware, firmware, maint, GUI sections
2026-10-12 V5.31: runtime sleep schedule + upload hour
    - Settings: bench/off-peak/peak/day wake zones, upload hour (NVS bikeset)
    - bike_mate.ino: currentWakeMode/currentWakeMs read config.* instead of
    compile-time BENCH_MODE / WAKE_*_MS / NIGHT_*_HOUR
    - Settings.cpp: extractInt helper, s.* extraction block, commit block,
    settingsToJson s block emission
    - DriveUpload.cpp: use config.uploadHour, include Settings.h
    - WifiMail.cpp: runtime config.benchMode gate instead of #if BENCH_MODE
    - Config.h: bump BIKE_MATE_VERSION 5.30 -> 5.31
    Known issue (deferred): boot banner prints pre-settingsLoad defaults,
    not loaded NVS values. Runtime unaffected.
2026-10-12 GUI 4.41: kick maint probe immediately on activate
    - activate_maintenance resets _maint_probe_last so the next tick()
    fires the probe without waiting up to 15s. Maint state flips ON
    as soon as the bike's HTTP server responds, not on the next
    probe cadence.
    - GUI_VERSION 4.40 -> 4.41
2026-10-12 V5.34: black box HB, WiFi flap fix, capture log gate
    Firmware cleanup:
    - Config.h: version 5.33 -> 5.34, DEBUG_CAPTURE=0, BB_HEARTBEAT_MS=60000
    - bike_mate.ino: banner prints loaded NVS values (settingsLoad before banner),
    [LOOP] alive removed, HB called from doStateWork, capture writes quieted
    - WakeLogger.cpp: black_box_heartbeat() every 60s writes HB row to current
    wake file; wakeLoggerForceWrite quiet during 100ms capture loop
    - DriveUpload.cpp: Rule7 log hoisted out of per-file loop; skip wifiBringUp
    when invoked from maint (was tearing down a live WiFi and double-registering
    WiFi.onEvent, causing duplicate [WIFI-EVENT] logs)
    - WifiManager.cpp: WiFi.onEvent registered once, not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
2026-10-12 GUI 4.43: remove Last Ride widget, show wake mode
    - app.py: drop the Last Ride box, its tick() update, the Reports
    menu entry, and both open_last_ride_report methods
    - app.py: add wake_lbl under the state label; displays
    SLEEP · BENCH|DAY|PEAK|OFFPEAK from the new wm field
    - reports.py: remove WaitingForRide and LastRideReport
    - config.py: GUI_VERSION 4.41 -> 4.43
    Last-ride pull was BLE-only and was lost when the GUI's BLE client
    was retired for OSA; restoring requires an OSA /bike/latest_ride
    route. Wake mode is now emitted by firmware V5.35 in the DATA
    notify and flows through OSA's cache automatically.
2026-10-12 V5.36: remove dead black_box_heartbeat()
    V5.34 added black_box_heartbeat() to write HB rows to the wake CSV
    via wakeLoggerLogEvent. It never fired: the throttle used millis(),
    which resets on every deep-sleep boot and never exceeded the 60s
    threshold in a 12s bench wake window.
    The 24h black box lives on the Mac: OSA v1.7 appends every HB it
    receives over BLE to ~/bike-mate-hb/hb-YYYY-MM-DD.log. The wake-file
    HB path is redundant and removed.
    - WakeLogger.cpp: delete black_box_heartbeat()
    - WakeLogger.h: delete declaration
    - bike_mate.ino: delete call site in doStateWork
    - Config.h: BIKE_MATE_VERSION 5.35 -> 5.36
    HB over BLE to OSA still works (publishBLE emits the hb block).
    Verified on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
2026-10-14 docs: veroboard layout and BOM
2026-10-14 V5.63 veroboard layout + build tracker (3A fuse, ADC filter, strapping notes)
2026-10-14 veroboard: expand to 20-strip A-T layout, on-board modules, 51x89mm board
2026-10-15 hardware: KiCad schematic + netlist (ERC-clean, prior versions archived)
2026-10-15 docs: rewrite veroboard guide for V6 board layout
2026-10-15 docs: add ESP32-C3 31mm antenna mod section
2026-10-16 docs: sync veroboard.md BOM with final design; add VeeCAD-ready protel netlist
2026-10-16 chore: ignore kicad_prl
2026-10-16 docs: OSA integration notes from Fan-Mate session
2026-10-16 gui 4.51: reports pick newest per day, skip 0V rows; drop local OTA/Drive HTTP servers
2026-10-17 docs(veroboard): board 37x24, module footprints, J4=switch header, M3 single USB-A
2026-10-17 net: VeroRoute-format netlist (PADS for modules, stock footprints)
2026-10-17 net: fix U1 pin names to numeric for PADS16 import
2026-10-18 Lock in final V8 veroboard guide (24x37 board)
2026-10-18 Separate MOSFET driver to GPIO7 (V5.67) and lock in V8 guide
2026-10-18 Update veroboard.md with correct 24x37 board and MOSFET notes
2026-10-18 V5.72: files count in telemetry, 15s timers, 30s cooldown, silent force logs
2026-10-30 V5.81: calibrated voltage/temp, 100-line serial buffer
2026-10-30 V5.81: voltage/temp calibration, 100-line buffer, production board status
2026-10-31 V5.83: fix NTC formula for pull-up to 3.3V, remove offset
2026-10-31 V5.84: calibrated analogReadMilliVolts for NTC
2026-10-31 V5.85: final voltage calibration (0.007866f)
2026-10-31 docs: add official Bike-Mate case STL and 3MF
2026-10-31 V5.93: secret menu double-click with red LED, field mode defaults
2026-11-02 V6.36: remove GPS heartbeat, stall function, duplicate GPS assignment
